gabrielfbdiniz/BMS-5S-L99BM114/BMS_5S_v2/fabrication/bom/mouser_bom_BMS_5S_L99BM114.csv

Manufacturer Part Number | Manufacturer | Quantity | Customer Reference | Description
L99BM114-TR | STMicroelectronics | 1 | IC1 | Automotive BMS Controller ASIC TQFP-64
HMU2103NL | Pulse Electronics | 2 | T1, T2 | Automotive Isolation Pulse Transformer 2.5kV SMD
USBLC6-2SC6 | STMicroelectronics | 2 | U2, U3 | Low Capacitance ESD Protection SOT-23-6
SMA6T68AY | STMicroelectronics | 1 | D1 | Automotive TVS Diode 600W SMA
STL8N10LF3 | STMicroelectronics | 1 | Q1 | N-Channel MOSFET 100V 8A PowerFLAT
STD105N10F7AG | STMicroelectronics | 1 | Q2 | Automotive N-Channel MOSFET 100V TO-252 DPAK
43045-1600 | Molex | 1 | J3 | Connector Header R/A 16 Pos Micro-Fit 3.0
43045-0400 | Molex | 2 | J4, J5 | Connector Header R/A 4 Pos Micro-Fit 3.0
CRCW201039R0FKEF | Vishay | 6 | R6, R9, R10, R13, R14, R17 | Resistor 39 Ohm 0.75W 1% 2010 SMD
CRCW0603100RFKEA | Vishay | 8 | R4, R7, R8, R11, R12, R15, R16, R25 | Resistor 100 Ohm 1/10W 1% 0603 SMD
CRCW060360R4FKEA | Vishay | 4 | R51, R52, R53, R54 | Resistor 60.4 Ohm 1/10W 1% 0603 SMD
CRCW2512100RFKEG | Vishay | 2 | R26, R27 | Resistor 100 Ohm 1W 1% 2512 SMD
CRCW251247R0FKEG | Vishay | 1 | R3 | Resistor 47 Ohm 1W 1% 2512 SMD
CRCW080510K0FKEA | Vishay | 8 | R33, R34, R35, R36, R41, R42, R43, R48 | Resistor 10k Ohm 1/8W 1% 0805 SMD
CRCW08053K90FKEA | Vishay | 7 | R37, R38, R39, R40, R44, R45, R46 | Resistor 3.9k Ohm 1/8W 1% 0805 SMD
CRCW060310K0FKEA | Vishay | 2 | R30, R55 | Resistor 10k Ohm 1/10W 1% 0603 SMD
CRCW0603100KFKEA | Vishay | 2 | R1, R31 | Resistor 100k Ohm 1/10W 1% 0603 SMD
CRCW06031K00FKEA | Vishay | 2 | R2, R5 | Resistor 1k Ohm 1/10W 1% 0603 SMD
CRCW06032K20FKEA | Vishay | 1 | R47 | Resistor 2.2k Ohm 1/10W 1% 0603 SMD
GRM188R72A473KE01D | Murata | 7 | C11, C13, C14, C17, C18, C21, C22 | Capacitor Ceramic 47nF 100V X7R 0603
GRM188R71H103KA01D | Murata | 6 | C12, C15, C16, C19, C20, C42 | Capacitor Ceramic 10nF 50V X7R 0603
GRM188R72A473KE01D | Murata | 2 | C23, C27 | Capacitor Ceramic 47nF 100V X7R 0603
GRM188R71H104KA93D | Murata | 7 | C35, C36, C37, C38, C39, C40, C41 | Capacitor Ceramic 100nF 50V X7R 0603
GRM1885C1H220JA01D | Murata | 4 | C44, C45, C47, C48 | Capacitor Ceramic 22pF 50V C0G 0603
GRM188R71H103KA01D | Murata | 2 | C43, C46 | Capacitor Ceramic 10nF 50V X7R 0603
GRM1885C2A101JA01D | Murata | 1 | C1 | Capacitor Ceramic 100pF 100V C0G 0603
C1608X7R2A333K080AA | TDK | 1 | C2 | Capacitor Ceramic 33nF 100V X7R 0603
GRM32ER72A225KA35L | Murata | 1 | C3 | Capacitor Ceramic 2.2uF 100V X7R 1210
GRM31CR71C475KA01L | Murata | 1 | C4 | Capacitor Ceramic 4.7uF 16V X7R 1206
GRM188R72A104KA35D | Murata | 1 | C5 | Capacitor Ceramic 100nF 100V X7R 0603
GRM188R71H472KA01D | Murata | 1 | C6 | Capacitor Ceramic 4.7nF 50V X7R 0603
GRM188R71C224KA01D | Murata | 1 | C7 | Capacitor Ceramic 220nF 16V X7R 0603
GRM21BR71A225KA01L | Murata | 1 | C8 | Capacitor Ceramic 2.2uF 10V X7R 0805
GRM21BR71C225KA12L | Murata | 1 | C9 | Capacitor Ceramic 2.2uF 16V X7R 0805
GRM21BR71E105KA99L | Murata | 1 | C10 | Capacitor Ceramic 1uF 25V X7R 0805
GRM32ER71C106KA12L | Murata | 1 | C24 | Capacitor Ceramic 10uF 16V X7R 1210
C0603C683K5RACTU | Kemet | 1 | C25 | Capacitor Ceramic 68nF 50V X7R 0603
GRM1885C1H330JA01D | Murata | 1 | C26 | Capacitor Ceramic 33pF 50V C0G 0603
GRM21BR71E105KA99L | Murata | 2 | C30, C33 | Capacitor Ceramic 1uF 25V X7R 0805
MMZ2012S102AT000 | TDK | 8 | FB1, FB2, FB3, FB4, FB5, FB6, FB7, FB8 | Ferrite Bead 1k Ohm @ 100MHz 0805
APT2012SGC | Kingbright | 1 | D4 | LED Super Bright Green 568nm 0805 SMD
