gabrielfbdiniz/BMS-5S-L99BM114/BMS_5S_v2/fabrication/bom/BMS_5S_L99BM114_bom.csv

Refs | Value | Footprint | Qty | DNP
C1 | 100pF/100V | Capacitor_SMD:C_0603_1608Metric_Pad1.08x0.95mm_HandSolder | 1
C2 | 33nF/100V | Capacitor_SMD:C_0603_1608Metric_Pad1.08x0.95mm_HandSolder | 1
C3 | 2u2F/100V | Capacitor_SMD:C_1210_3225Metric_Pad1.33x2.70mm_HandSolder | 1
C4 | 4u7F/16V | Capacitor_SMD:C_1206_3216Metric_Pad1.33x1.80mm_HandSolder | 1
C5 | 100nF/100V | Capacitor_SMD:C_0603_1608Metric_Pad1.08x0.95mm_HandSolder | 1
C6 | 4.7nF | Capacitor_SMD:C_0603_1608Metric_Pad1.08x0.95mm_HandSolder | 1
C7 | 220nF/16V | Capacitor_SMD:C_0603_1608Metric_Pad1.08x0.95mm_HandSolder | 1
C8 | 2u2F/6.3V | Capacitor_SMD:C_0805_2012Metric_Pad1.18x1.45mm_HandSolder | 1
C9 | 2u2F/16V | Capacitor_SMD:C_0805_2012Metric_Pad1.18x1.45mm_HandSolder | 1
C10 | 1uF/16V | Capacitor_SMD:C_0805_2012Metric_Pad1.18x1.45mm_HandSolder | 1
C11,C13,C14,C17,C18,C21,C22 | 47nF/100V | Capacitor_SMD:C_0603_1608Metric_Pad1.08x0.95mm_HandSolder | 7
C12,C15,C16,C19,C20,C42 | 10nF/50V | Capacitor_SMD:C_0603_1608Metric_Pad1.08x0.95mm_HandSolder | 6
C23,C27 | 47nF@100V | Capacitor_SMD:C_0603_1608Metric_Pad1.08x0.95mm_HandSolder | 2
C24 | 10uF@10V | Capacitor_SMD:C_1210_3225Metric_Pad1.33x2.70mm_HandSolder | 1
C25 | 68nF@10V | Capacitor_SMD:C_0603_1608Metric_Pad1.08x0.95mm_HandSolder | 1
C26 | 33pF@10V | Capacitor_SMD:C_0603_1608Metric_Pad1.08x0.95mm_HandSolder | 1
C30,C33 | 1uF | Capacitor_SMD:C_0805_2012Metric_Pad1.18x1.45mm_HandSolder | 2
C35-C41 | 100nF | Capacitor_SMD:C_0603_1608Metric_Pad1.08x0.95mm_HandSolder | 7
C43,C46 | 10nF | Capacitor_SMD:C_0603_1608Metric_Pad1.08x0.95mm_HandSolder | 2
C44,C45,C47,C48 | 22pF | Capacitor_SMD:C_0603_1608Metric_Pad1.08x0.95mm_HandSolder | 4
D1 | SMA6T68AY | DIOM5126X265N:DIOM5126X265N | 1
D4 | 3.2V | LED_SMD:LED_0805_2012Metric_Pad1.15x1.40mm_HandSolder | 1
FB1-FB8 | 1k@100MHz | Inductor_SMD:L_0805_2012Metric_Pad1.05x1.20mm_HandSolder | 8
IC1 | L99BM114-TR | Package_QFP:TQFP-64-1EP_10x10mm_P0.5mm_EP5.305x5.305mm | 1
J3 | Conector | Connector_Molex:Molex_Micro-Fit_3.0_43045-1600_2x08_P3.00mm_Horizontal | 1
J4,J5 | Conn_02x02_Counter_Clockwise | Connector_Molex:Molex_Micro-Fit_3.0_43045-0400_2x02_P3.00mm_Horizontal | 2
Q1 | STL8N10LF3 | STL8N10LF3:STL8N10LF3 | 1
Q2 | Q_NMOS_GDS | Package_TO_SOT_SMD:TO-252-2 | 1
R1,R31 | 100k | Resistor_SMD:R_0603_1608Metric_Pad0.98x0.95mm_HandSolder | 2
R2,R5 | 1k | Resistor_SMD:R_0603_1608Metric_Pad0.98x0.95mm_HandSolder | 2
R3 | 47 | Resistor_SMD:R_2512_6332Metric_Pad1.40x3.35mm_HandSolder | 1
R4,R7,R8,R11,R12,R15,R16,R25 | 100@1/16W | Resistor_SMD:R_0603_1608Metric_Pad0.98x0.95mm_HandSolder | 8
R6,R9,R10,R13,R14,R17 | 39@3/4W | Resistor_SMD:R_2010_5025Metric_Pad1.40x2.65mm_HandSolder | 6
R26,R27 | 100@1W | Resistor_SMD:R_2512_6332Metric_Pad1.40x3.35mm_HandSolder | 2
R30,R55 | 10k | Resistor_SMD:R_0603_1608Metric_Pad0.98x0.95mm_HandSolder | 2
R33-R36,R41-R43,R48 | 10k | Resistor_SMD:R_0805_2012Metric_Pad1.20x1.40mm_HandSolder | 8
R37-R40,R44-R46 | 3k9 | Resistor_SMD:R_0805_2012Metric_Pad1.20x1.40mm_HandSolder | 7
R47 | 2k2 | Resistor_SMD:R_0603_1608Metric_Pad0.98x0.95mm_HandSolder | 1
R49,R50 | 0R | Resistor_SMD:R_0603_1608Metric_Pad0.98x0.95mm_HandSolder | 2 | DNP
R51-R54 | 60.4 | Resistor_SMD:R_0603_1608Metric_Pad0.98x0.95mm_HandSolder | 4
T1,T2 | HMU2103NL | HMU2103NL:HMU2103NL | 2
U2,U3 | USBLC6-2SC6 | Package_TO_SOT_SMD:SOT-23-6 | 2
