gabrielfbdiniz/BMS-5S-L99BM114/BMS_5S_v2/3dmodels/HMU2103NL.stp

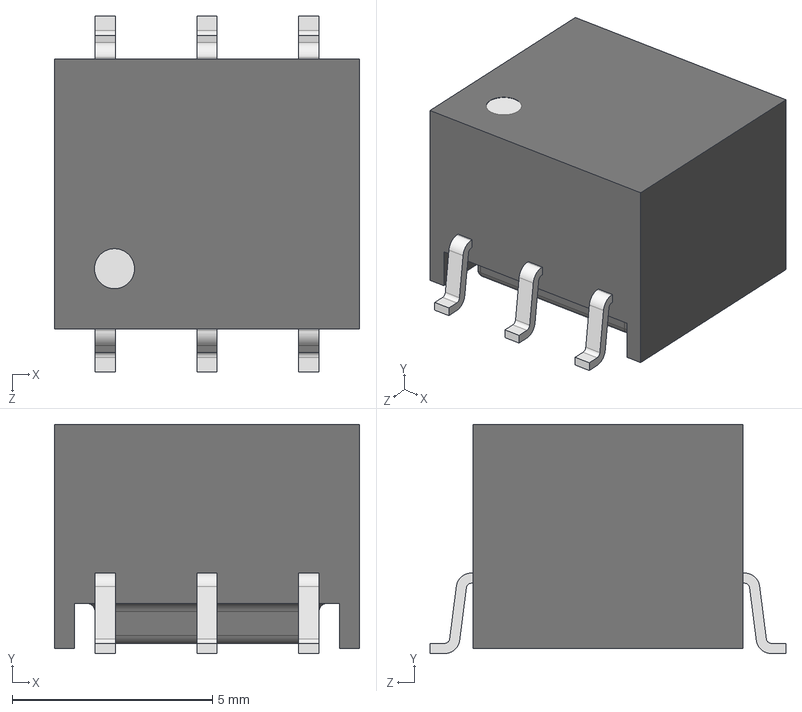
[picture p5: CAD file, 2026-10-21]
BMS_5S_v2/3dmodels/HMU2103NL.stp
7.62 x 5.72 x 8.89 mm
