gabrielfbdiniz/BMS-5S-L99BM114/BMS_5S_v2/3dmodels/Molex_43045-0400.step

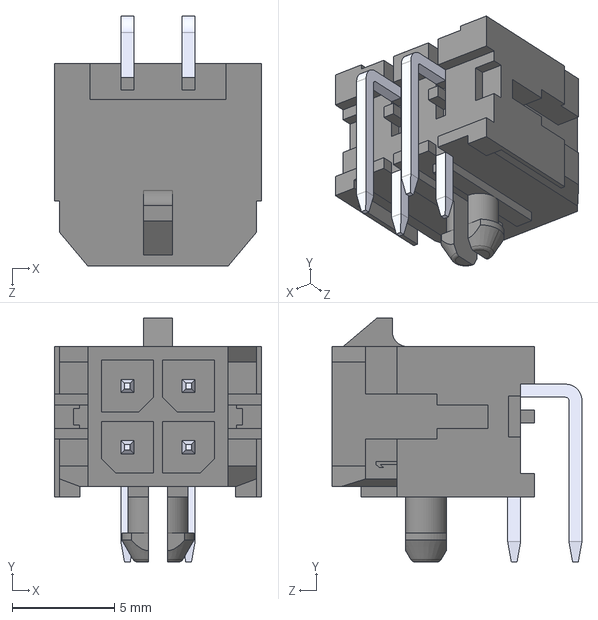
[picture p6: CAD file, 2026-10-21]
BMS_5S_v2/3dmodels/Molex_43045-0400.step
10.1 x 12.0 x 12.2 mm
