gabrielfbdiniz/BMS-5S-L99BM114/BMS_5S_v2/3dmodels/430451600.stp

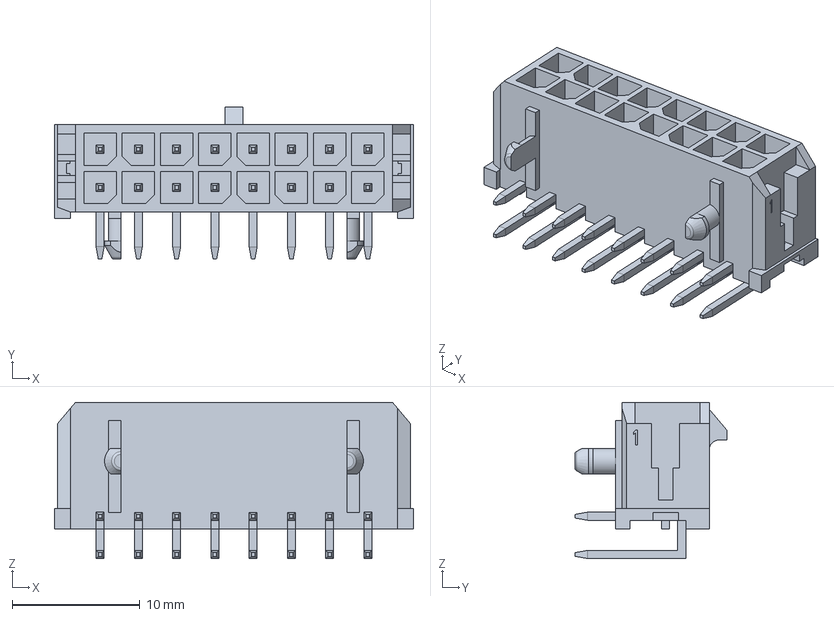
[picture p7: CAD file, 2026-10-21]
BMS_5S_v2/3dmodels/430451600.stp
28.1 x 11.9 x 12.2 mm
