gabrielfbdiniz/BMS-5S-L99BM114/BMS_5S_v2/fabrication/BMS_5S_L99BM114_Schematic.pdf

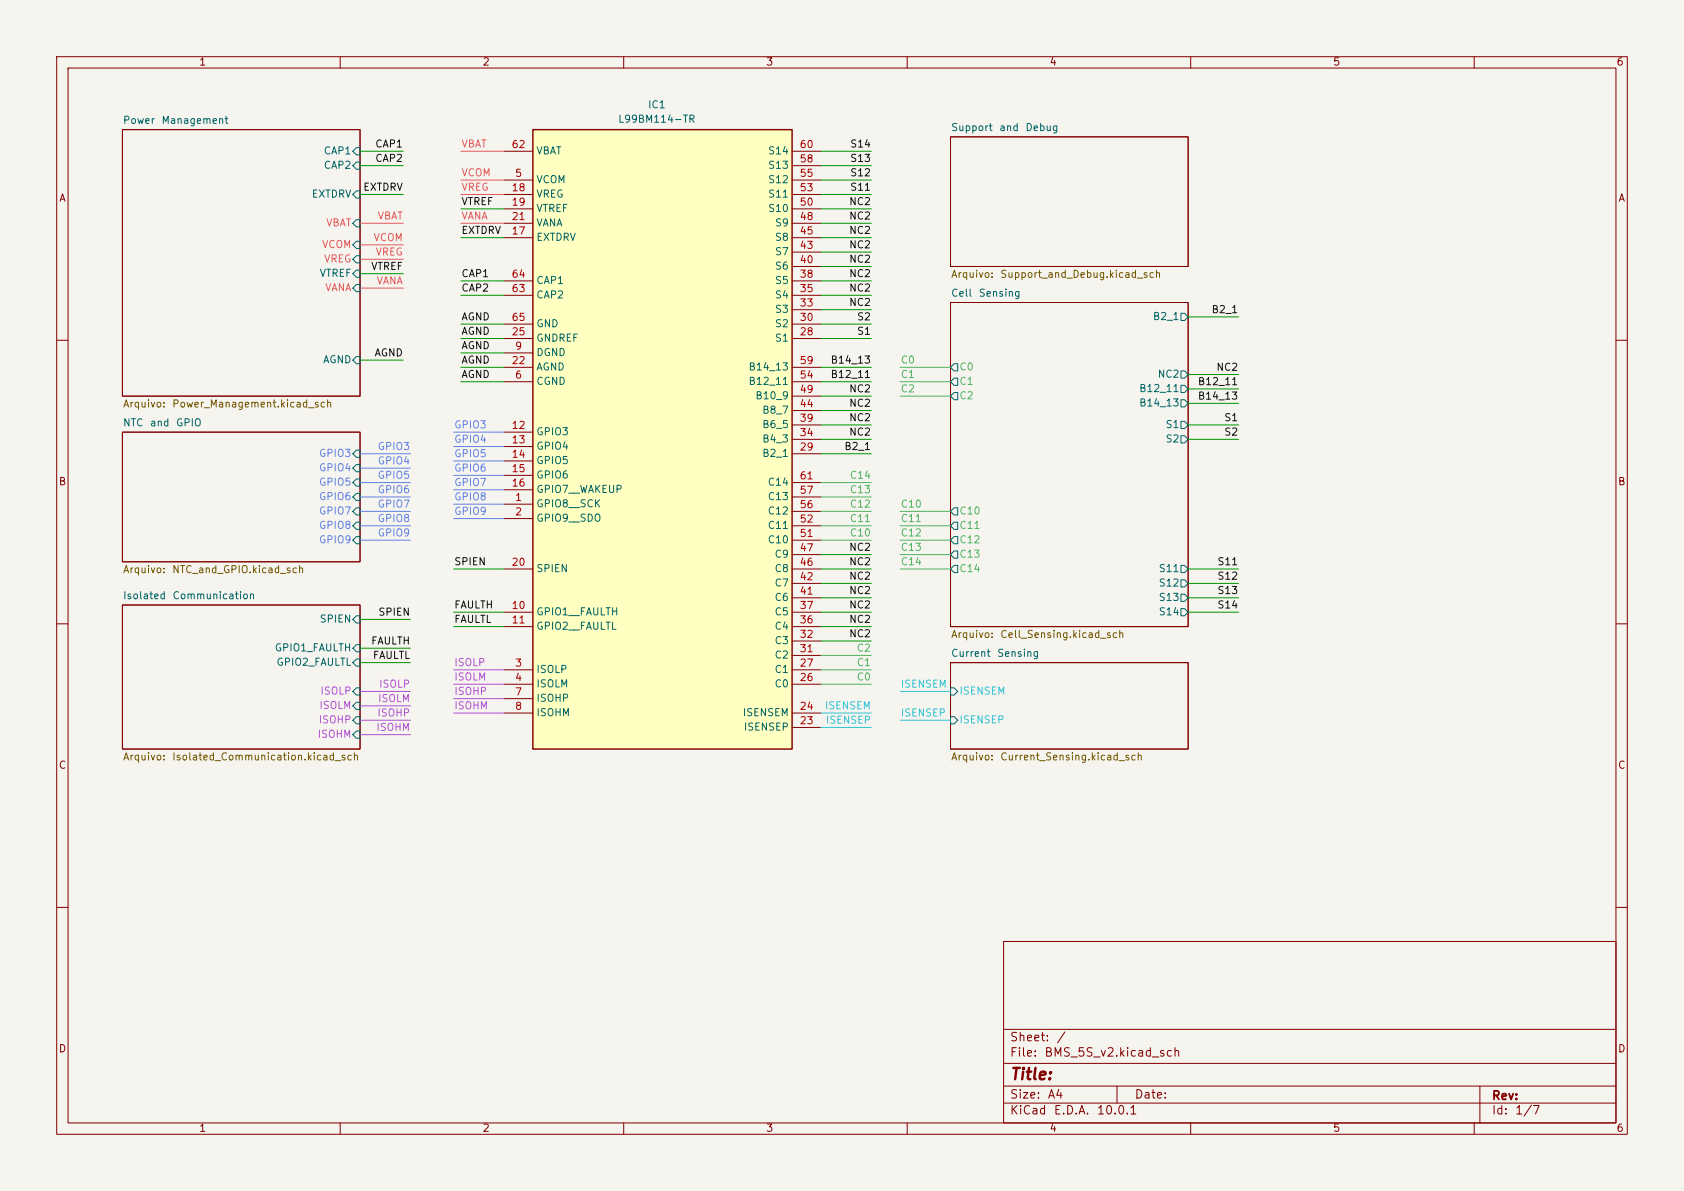
[picture p8: page 1]

Arquivo: Power_Management.kicad_sch
Arquivo: Cell_Sensing.kicad_sch GPIO3 GPIO4 GPIO5 GPIO6 GPIO7 GPIO8 GPIO9 NTC and GPIO

Size: A4 | Rev:
KiCad E.D.A. 10.0.1 | Id: 1/7

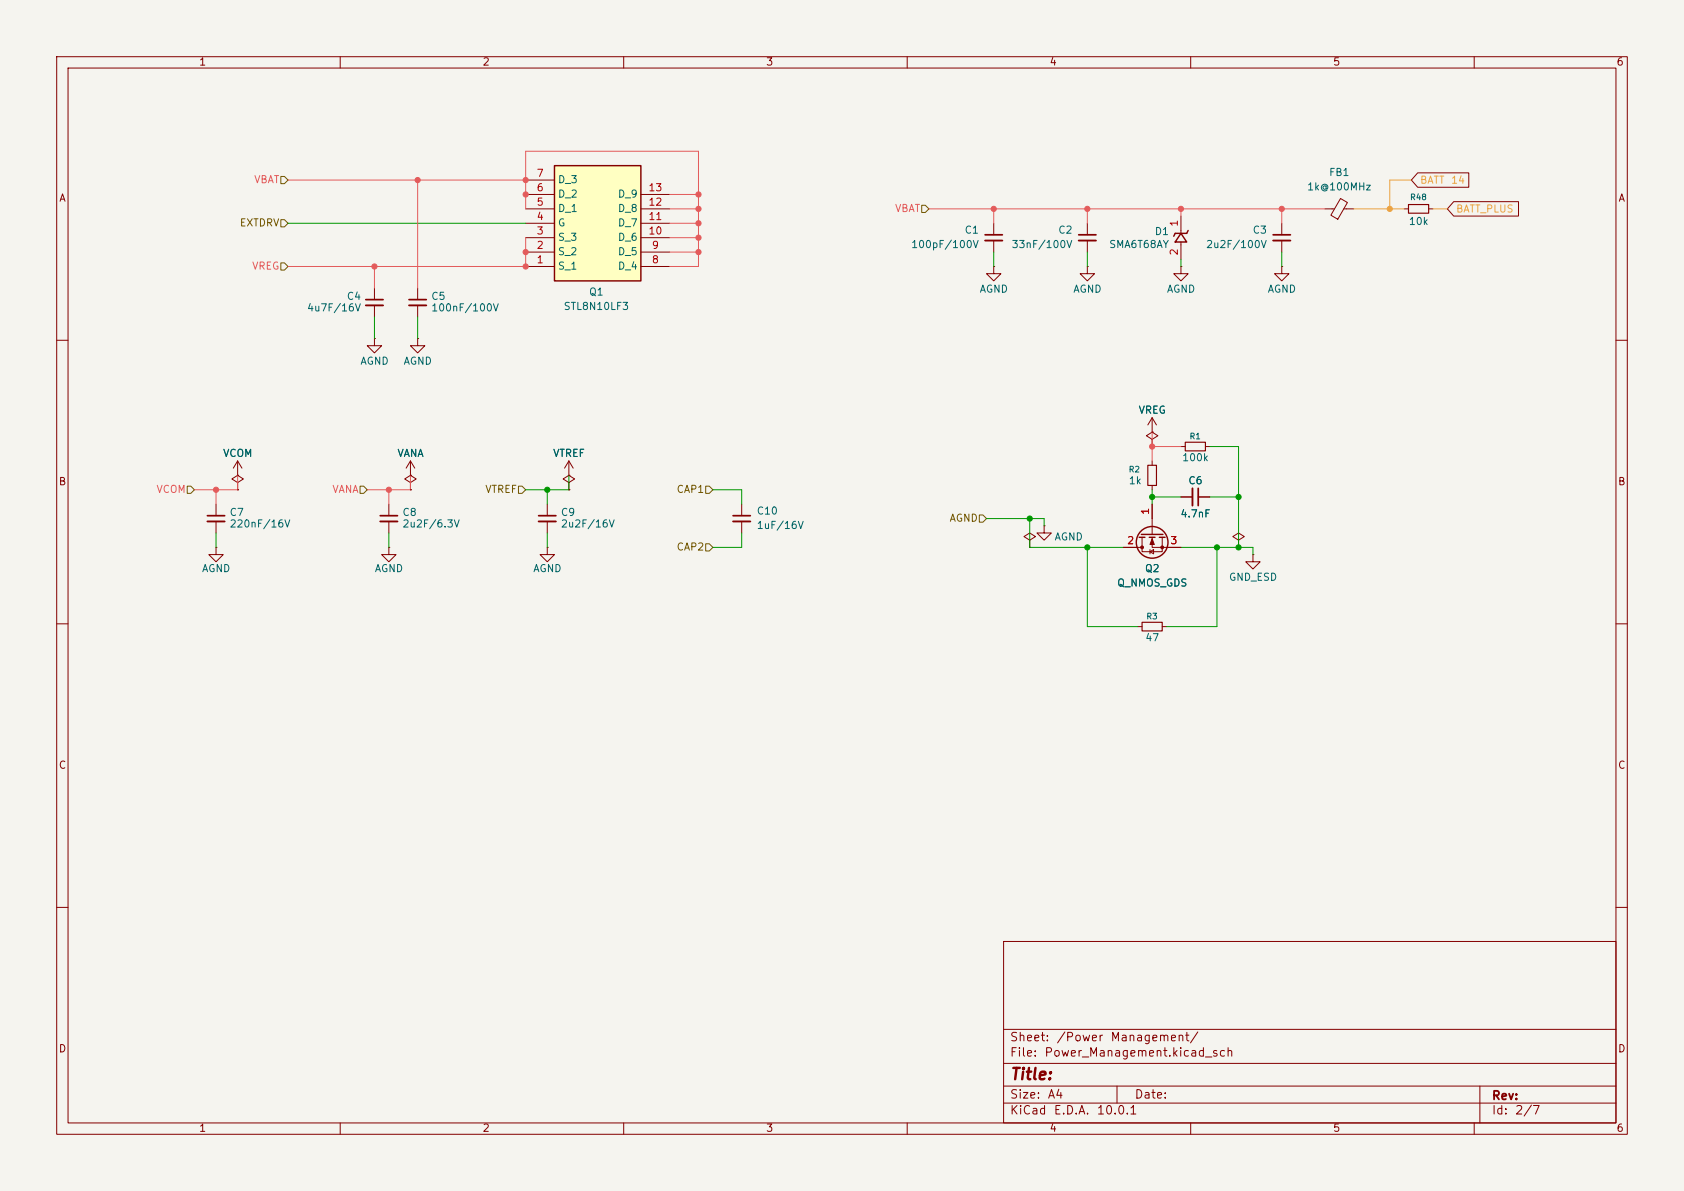
[picture p9: page 2]

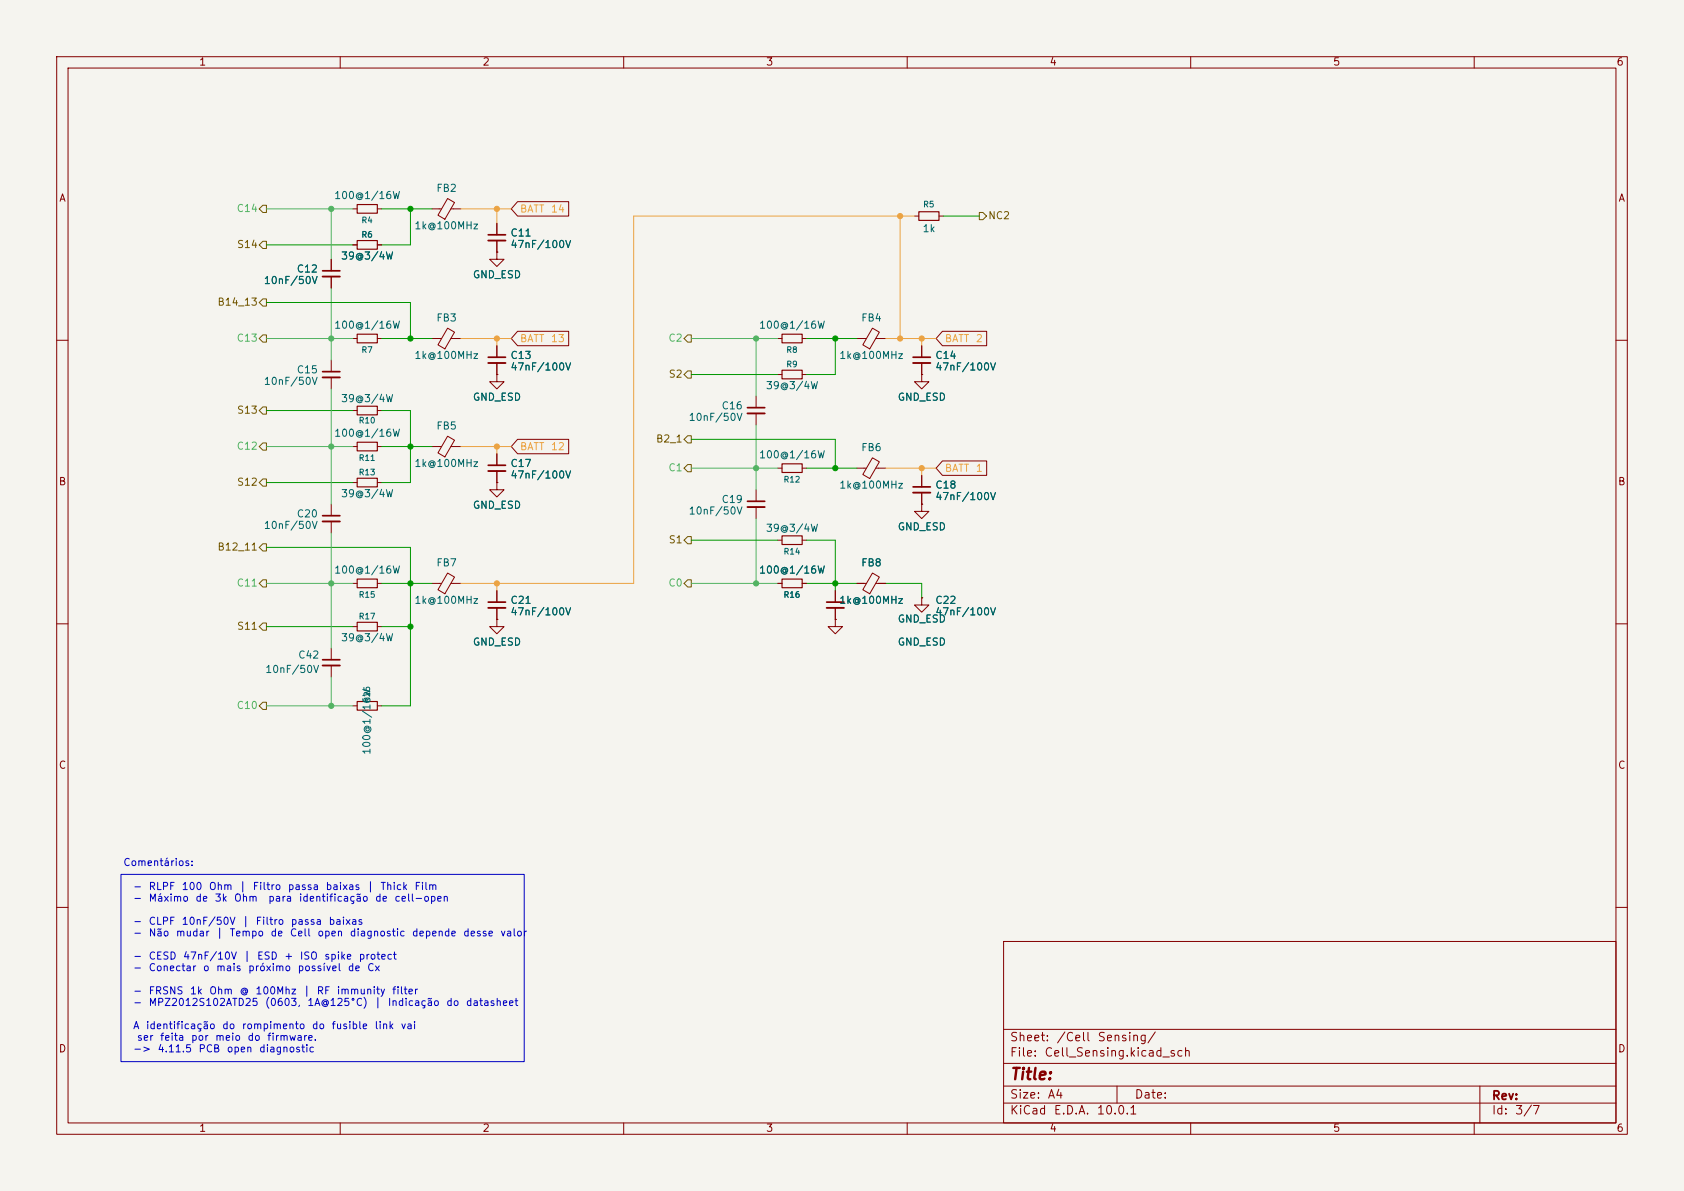
[picture p10: page 3]

- Máximo de 3k Ohm para identificação de cell-open - CLPF 10nF/50V | Filtro passa baixas - Não mudar | Tempo de Cell open diagnostic depende desse valor - CESD 47nF/10V | ESD + ISO spike protect - Conectar o mais próximo possível de Cx - FRSNS 1k Ohm @ 100Mhz | RF immunity filter - MPZ2012S102ATD25 (0603, 1A@125°C) | Indicação do datasheet A identificação do rompimento do fusible link vai ser feita por meio do firmware. -> 4.11.5 PCB open diagnostic

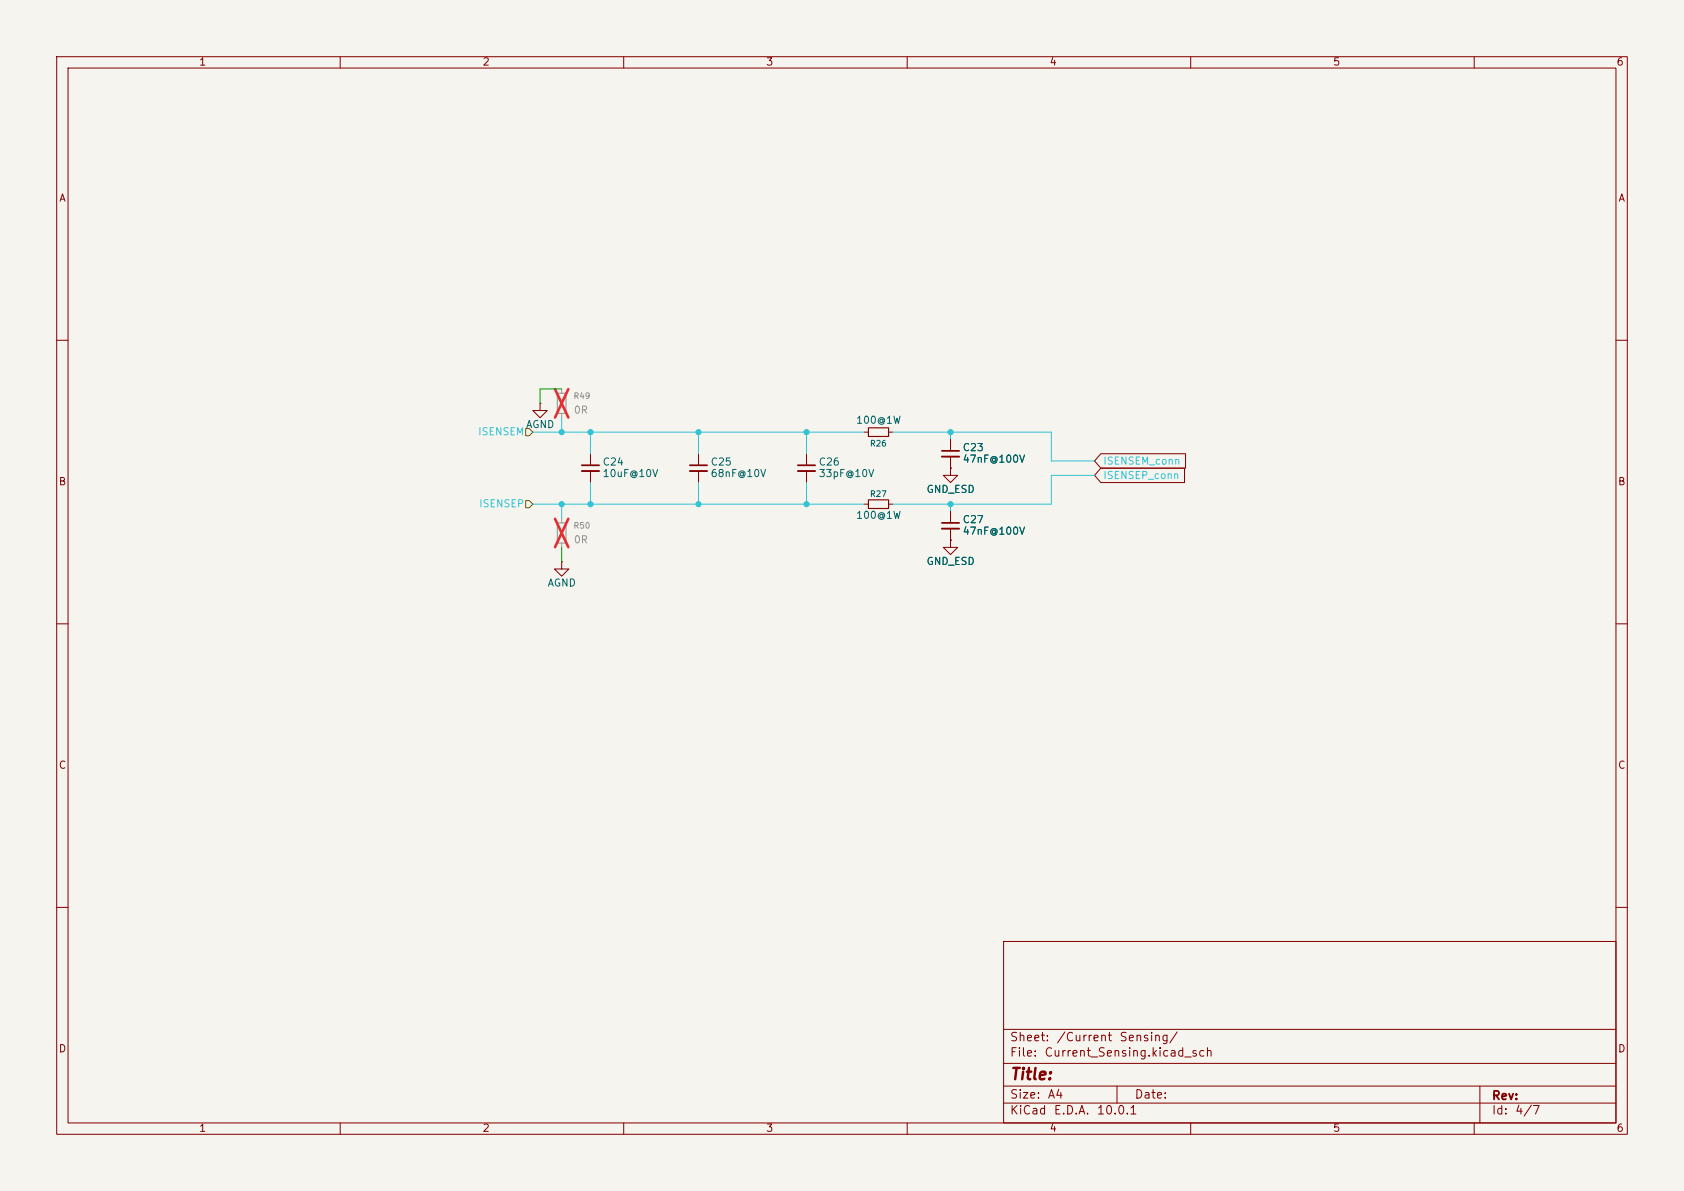
[picture p11: page 4]

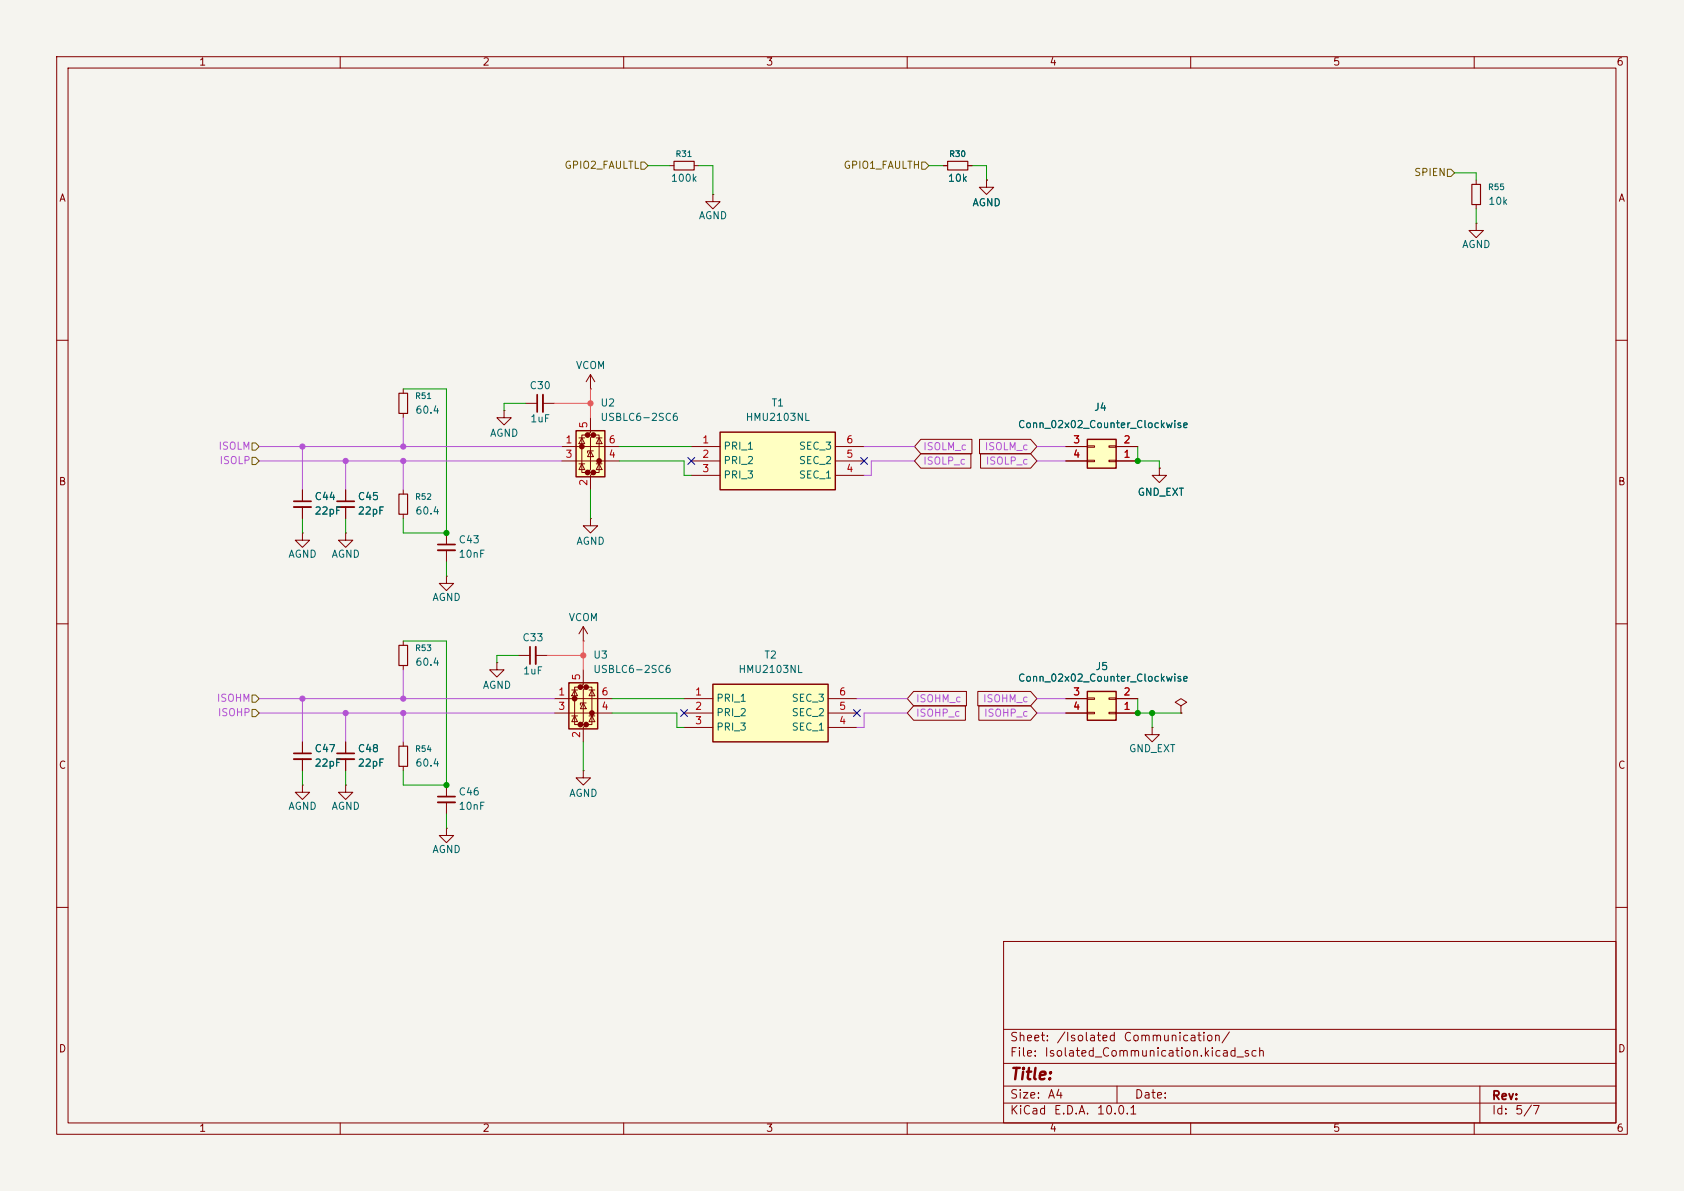
[picture p12: page 5]

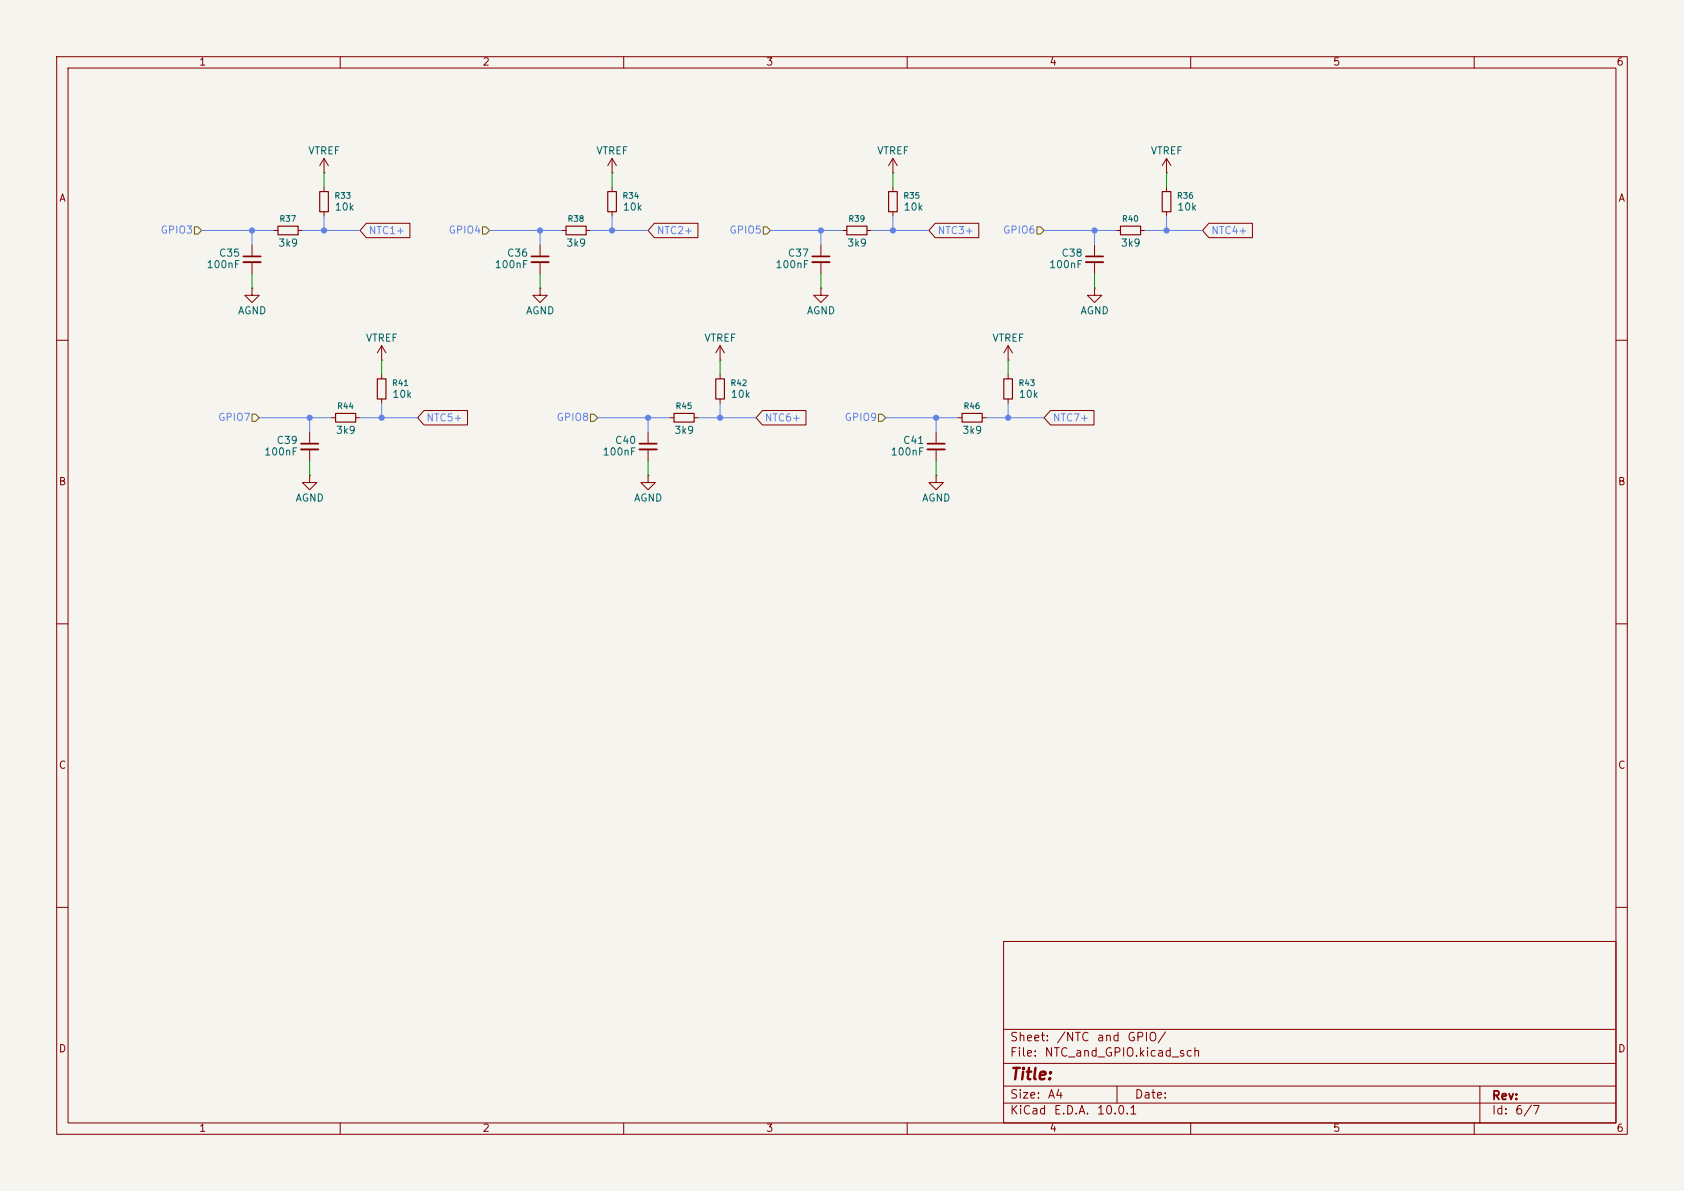
[picture p13: page 6]

Sheet: /NTC and GPIO/
File: NTC_and_GPIO.kicad_sch
Title:

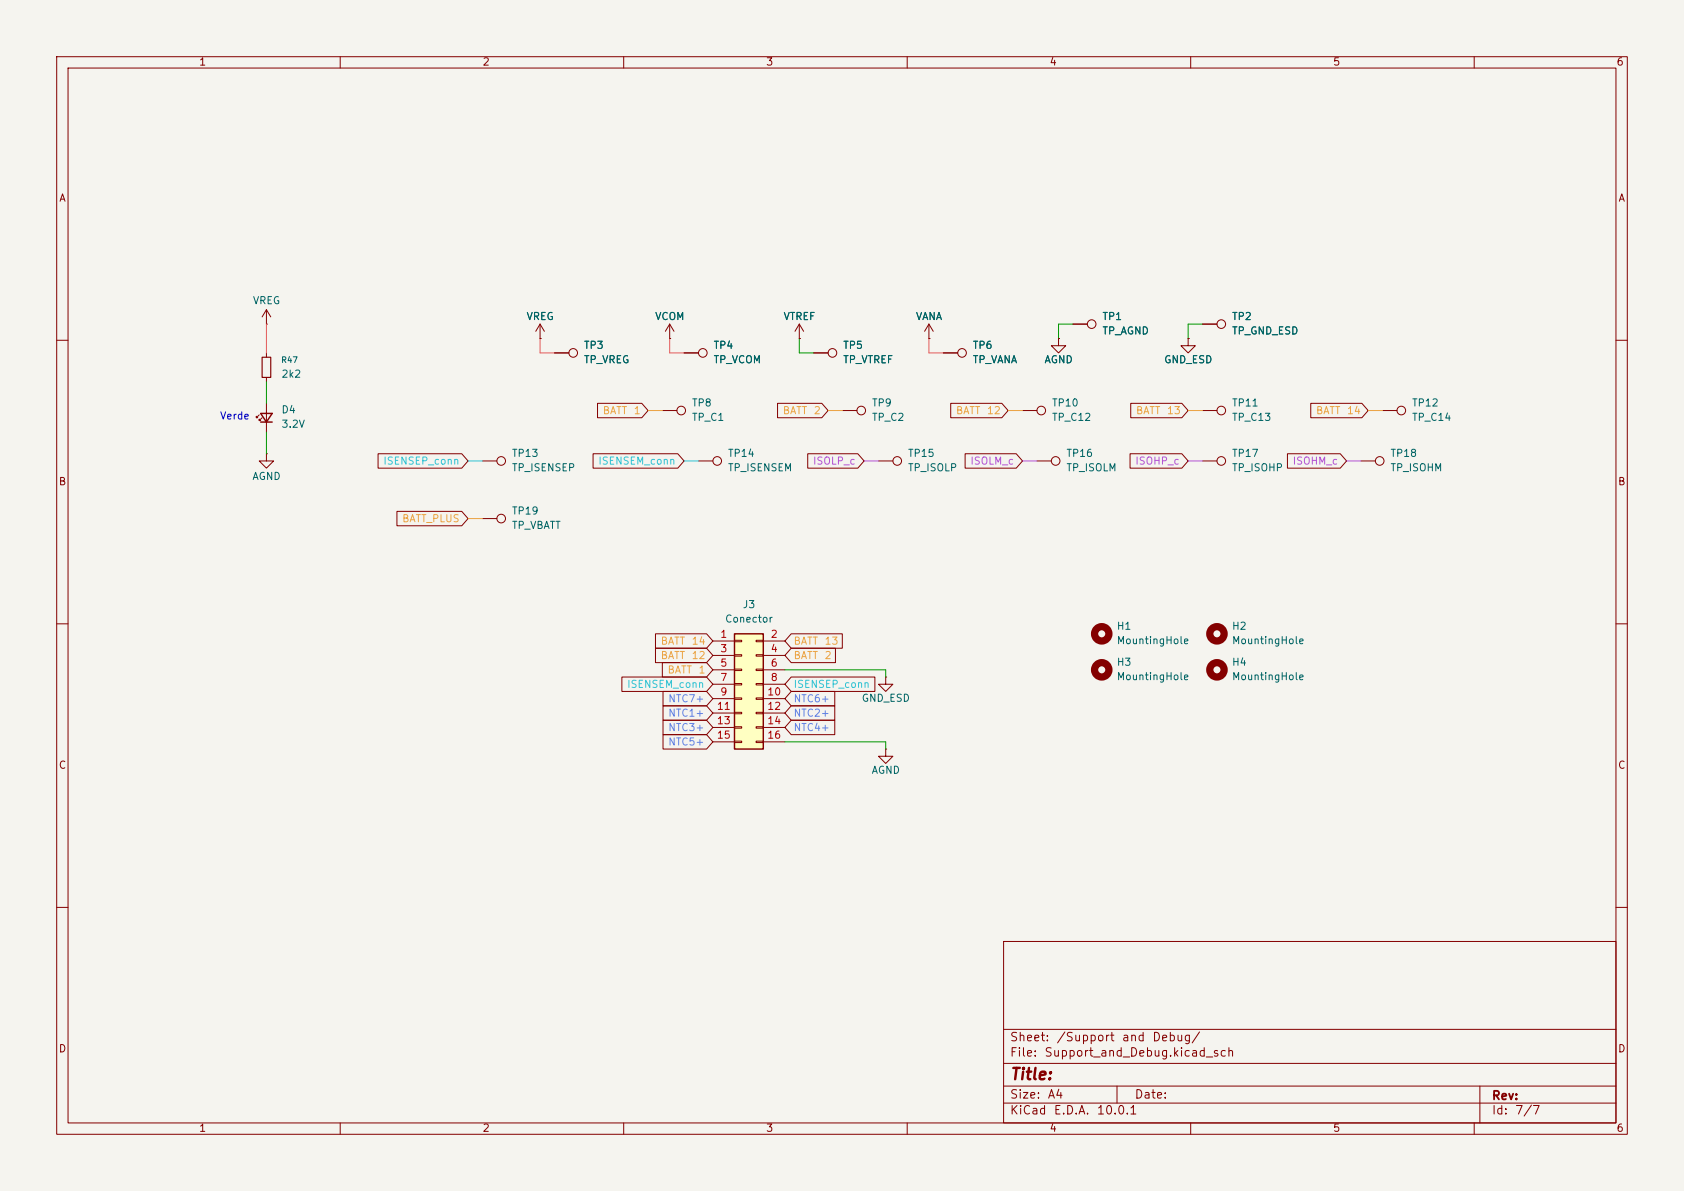
[picture p14: page 7]

Sheet: /Support and Debug/
File: Support_and_Debug.kicad_sch
Title:
