gabrielfbdiniz/BMS-5S-L99BM114/BMS_5S_v2/BMS_5S_v2.kicad_pcb

## KiCad design BMS_5S_v2/BMS_5S_v2.kicad_pcb (2026-10-22)

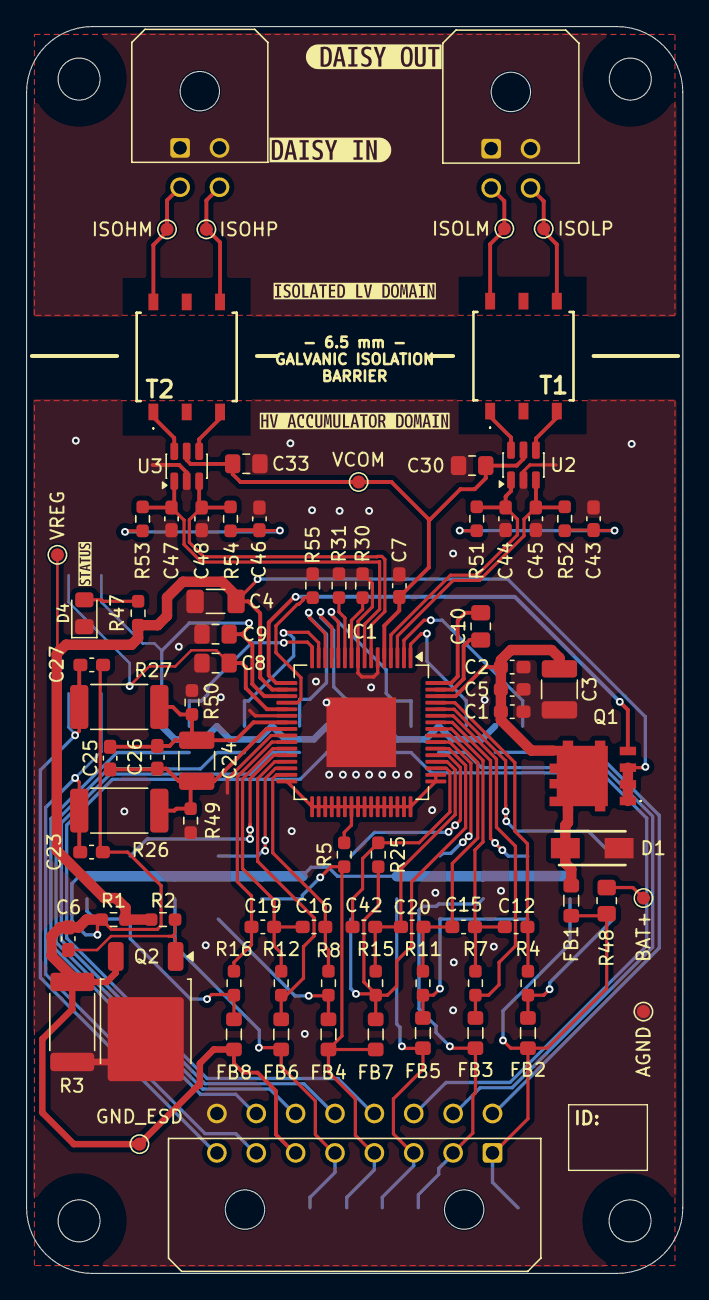
[picture p15: board BMS_5S_v2.kicad_pcb from above]

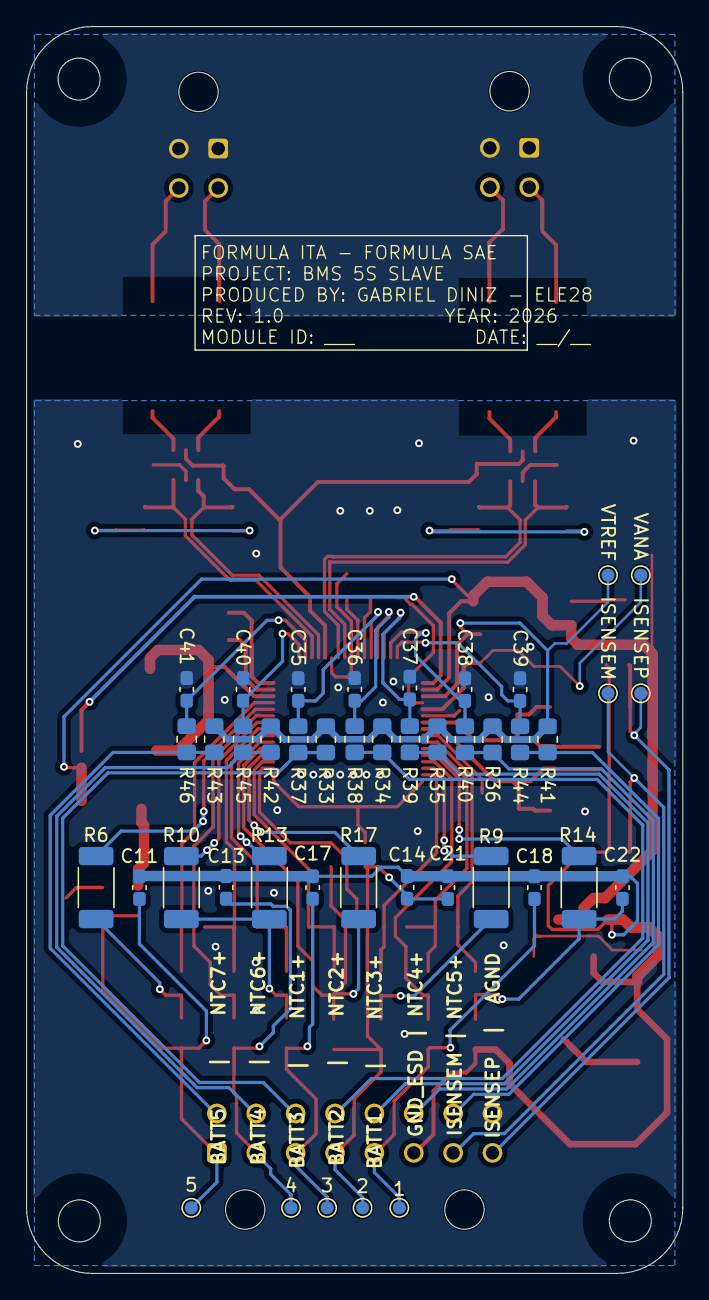
[picture p16: board BMS_5S_v2.kicad_pcb from below]

Board: 4 copper layers, 50.0 x 95.0 mm, 135 parts (43 on the bottom side), 76 nets.

Parts:
1: TP_C1; TestPoint_Pad_D1.0mm
2: TP_C2; TestPoint_Pad_D1.0mm
3: TP_C12; TestPoint_Pad_D1.0mm
4: TP_C13; TestPoint_Pad_D1.0mm
5: TP_C14; TestPoint_Pad_D1.0mm
AGND: TP_AGND; TestPoint_Pad_D1.0mm
BAT+: TP_VBATT; TestPoint_Pad_D1.0mm
C1: 100pF/100V; C_0603_1608Metric_Pad1.08x0.95mm_HandSolder
C2: 33nF/100V; C_0603_1608Metric_Pad1.08x0.95mm_HandSolder
C3: 2u2F/100V; C_1210_3225Metric_Pad1.33x2.70mm_HandSolder
C4: 4u7F/16V; C_1206_3216Metric_Pad1.33x1.80mm_HandSolder
C5: 100nF/100V; C_0603_1608Metric_Pad1.08x0.95mm_HandSolder
C6: 4.7nF; C_0603_1608Metric_Pad1.08x0.95mm_HandSolder
C7: 220nF/16V; C_0603_1608Metric_Pad1.08x0.95mm_HandSolder
C8: 2u2F/6.3V; C_0805_2012Metric_Pad1.18x1.45mm_HandSolder
C9: 2u2F/16V; C_0805_2012Metric_Pad1.18x1.45mm_HandSolder
C10: 1uF/16V; C_0805_2012Metric_Pad1.18x1.45mm_HandSolder
C11, C13, C14, C17, C18, C21, C22: 47nF/100V; C_0603_1608Metric_Pad1.08x0.95mm_HandSolder
C12, C15, C16, C19, C20, C42: 10nF/50V; C_0603_1608Metric_Pad1.08x0.95mm_HandSolder
C23, C27: 47nF@100V; C_0603_1608Metric_Pad1.08x0.95mm_HandSolder
C24: 10uF@10V; C_1210_3225Metric_Pad1.33x2.70mm_HandSolder
C25: 68nF@10V; C_0603_1608Metric_Pad1.08x0.95mm_HandSolder
C26: 33pF@10V; C_0603_1608Metric_Pad1.08x0.95mm_HandSolder
C30, C33: 1uF; C_0805_2012Metric_Pad1.18x1.45mm_HandSolder
C35, C36, C37, C38, C39, C40, C41: 100nF; C_0603_1608Metric_Pad1.08x0.95mm_HandSolder
C43, C46: 10nF; C_0603_1608Metric_Pad1.08x0.95mm_HandSolder
C44, C45, C47, C48: 22pF; C_0603_1608Metric_Pad1.08x0.95mm_HandSolder
D1: SMA6T68AY; DIOM5126X265N
D4: 3.2V; LED_0805_2012Metric_Pad1.15x1.40mm_HandSolder
FB1, FB2, FB3, FB4, FB5, FB6, FB7, FB8: 1k@100MHz; L_0805_2012Metric_Pad1.05x1.20mm_HandSolder
GND_ESD: TP_GND_ESD; TestPoint_Pad_D1.0mm
H1, H2, H3, H4: MountingHole; MountingHole_3.2mm_M3_DIN965
IC1: L99BM114-TR; TQFP-64-1EP_10x10mm_P0.5mm_EP5.305x5.305mm
ISENSEM: TP_ISENSEM; TestPoint_Pad_D1.0mm
ISENSEP: TP_ISENSEP; TestPoint_Pad_D1.0mm
ISOHM: TP_ISOHM; TestPoint_Pad_D1.0mm
ISOHP: TP_ISOHP; TestPoint_Pad_D1.0mm
ISOLM: TP_ISOLM; TestPoint_Pad_D1.0mm
ISOLP: TP_ISOLP; TestPoint_Pad_D1.0mm
J3: Conector; Molex_Micro-Fit_3.0_43045-1600_2x08_P3.00mm_Horizontal
J4, J5: Conn_02x02_Counter_Clockwise; Molex_Micro-Fit_3.0_43045-0400_2x02_P3.00mm_Horizontal
Q1: STL8N10LF3
Q2: Q_NMOS_GDS; TO-252-2
R1, R31: 100k; R_0603_1608Metric_Pad0.98x0.95mm_HandSolder
R2, R5: 1k; R_0603_1608Metric_Pad0.98x0.95mm_HandSolder
R3: 47; R_2512_6332Metric_Pad1.40x3.35mm_HandSolder
R4, R7, R8, R11, R12, R15, R16, R25: 100@1/16W; R_0603_1608Metric_Pad0.98x0.95mm_HandSolder
R6, R9, R10, R13, R14, R17: 39@3/4W; R_2010_5025Metric_Pad1.40x2.65mm_HandSolder
R26, R27: 100@1W; R_2512_6332Metric_Pad1.40x3.35mm_HandSolder
R30, R55: 10k; R_0603_1608Metric_Pad0.98x0.95mm_HandSolder
R33, R34, R35, R36, R41, R42, R43, R48: 10k; R_0805_2012Metric_Pad1.20x1.40mm_HandSolder
R37, R38, R39, R40, R44, R45, R46: 3k9; R_0805_2012Metric_Pad1.20x1.40mm_HandSolder
R47: 2k2; R_0603_1608Metric_Pad0.98x0.95mm_HandSolder
R49, R50: 0R; R_0603_1608Metric_Pad0.98x0.95mm_HandSolder
R51, R52, R53, R54: 60.4; R_0603_1608Metric_Pad0.98x0.95mm_HandSolder
T1, T2: HMU2103NL
U2, U3: USBLC6-2SC6; SOT-23-6
VANA: TP_VANA; TestPoint_Pad_D1.0mm
VCOM: TP_VCOM; TestPoint_Pad_D1.0mm
VREG: TP_VREG; TestPoint_Pad_D1.0mm
VTREF: TP_VTREF; TestPoint_Pad_D1.0mm
kibuzzard-6AD93452: G***; kibuzzard-6AD93452
kibuzzard-6AD93460: G***; kibuzzard-6AD93460
kibuzzard-6ADA909C: G***; kibuzzard-6ADA909C
kibuzzard-6ADA916E: G***; kibuzzard-6ADA916E
kibuzzard-6ADA9153: G***; kibuzzard-6ADA9153

Connections:
/B2_1: FB6.1, IC1.29 (B2_1), R12.2
/B12_11: FB7.1, IC1.54 (B12_11), R15.2, R17.2, R25.2
/B14_13: FB3.1, IC1.59 (B14_13), R7.2
/C0: C19.2, IC1.26 (C0), R16.1
/C1: C16.2, C19.1, IC1.27 (C1), R12.1
/C2: C16.1, IC1.31 (C2), R8.1
/C10: C42.2, IC1.51 (C10), R25.1
/C11: C20.2, C42.1, IC1.52 (C11), R15.1
/C12: C15.2, C20.1, IC1.56 (C12), R11.1
/C13: C12.2, C15.1, IC1.57 (C13), R7.1
/C14: C12.1, IC1.61 (C14), R4.1
/CAP1: C10.1, IC1.64 (CAP1)
/CAP2: C10.2, IC1.63 (CAP2)
/EXTDRV: IC1.17 (EXTDRV), Q1.4 (G)
/FAULTH: IC1.10 (GPIO1__FAULTH), R30.1
/FAULTL: IC1.11 (GPIO2__FAULTL), R31.1
/GPIO3: C35.1, IC1.12 (GPIO3), R37.1
/GPIO4: C36.1, IC1.13 (GPIO4), R38.1
/GPIO5: C37.1, IC1.14 (GPIO5), R39.1
/GPIO6: C38.1, IC1.15 (GPIO6), R40.1
/GPIO7: C39.1, IC1.16 (GPIO7__WAKEUP), R44.1
/GPIO8: C40.1, IC1.1 (GPIO8__SCK), R45.1
/GPIO9: C41.1, IC1.2 (GPIO9__SDO), R46.1
/ISENSEM: C24.1, C25.1, C26.1, IC1.24 (ISENSEM), R26.1, R49.2
/ISENSEP: C24.2, C25.2, C26.2, IC1.23 (ISENSEP), R27.2, R50.1
/ISOHM: C47.1, IC1.8 (ISOHM), R53.2, U3.1 (I/O1)
/ISOHP: C48.1, IC1.7 (ISOHP), R54.1, U3.3 (I/O2)
/ISOLM: C44.1, IC1.4 (ISOLM), R51.2, U2.1 (I/O1)
/ISOLP: C45.1, IC1.3 (ISOLP), R52.1, U2.3 (I/O2)
/NC2: IC1.32 (C3), IC1.33 (S3), IC1.34 (B4_3), IC1.35 (S4), IC1.36 (C4), IC1.37 (C5), IC1.38 (S5), IC1.39 (B6_5), IC1.40 (S6), IC1.41 (C6), IC1.42 (C7), IC1.43 (S7), IC1.44 (B8_7), IC1.45 (S8), IC1.46 (C8), IC1.47 (C9), IC1.48 (S9), IC1.49 (B10_9), IC1.50 (S10), R5.2
/S1: IC1.28 (S1), R14.1
/S2: IC1.30 (S2), R9.1
/S11: IC1.53 (S11), R17.1
/S12: IC1.55 (S12), R13.1
/S13: IC1.58 (S13), R10.1
/S14: IC1.60 (S14), R6.1
/SPIEN: IC1.20 (SPIEN), R55.1
/VBAT: C1.1, C2.1, C3.1, C5.1, D1.1 (K), FB1.1, IC1.62 (VBAT), Q1.5 (D_1), Q1.6 (D_2), Q1.7 (D_3), Q1.8 (D_4), Q1.9 (D_5), Q1.10 (D_6), Q1.11 (D_7), Q1.12 (D_8), Q1.13 (D_9)
AGND: AGND.1, C1.2, C2.2, C3.2, C4.2, C5.2, C7.2, C8.2, C9.2, C30.1, C33.1, C35.2, C36.2, C37.2, C38.2, C39.2, C40.2, C41.2, C43.2, C44.2, C45.2, C46.2, C47.2, C48.2, D1.2 (A), D4.1 (K), IC1.6 (CGND), IC1.9 (DGND), IC1.22 (AGND), IC1.25 (GNDREF), IC1.65 (GND), J3.16, Q2.2 (D), R3.1, R30.2, R31.2, R49.1, R50.2, R55.2, U2.2 (GND), U3.2 (GND)
BATT 1: 1.1, C18.1, FB6.2, J3.5
BATT 2: 2.1, C14.1, C21.1, FB4.2, FB7.2, J3.4, R5.1
BATT 12: 3.1, C17.1, FB5.2, J3.3
BATT 13: 4.1, C13.1, FB3.2, J3.2
BATT 14: 5.1, C11.1, FB1.2, FB2.2, J3.1, R48.1
BATT_PLUS: BAT+.1, R48.2
GND_ESD: C6.1, C11.2, C13.2, C14.2, C17.2, C18.2, C21.2, C22.2, C23.2, C27.2, FB8.2, GND_ESD.1, J3.6, Q2.3 (S), R1.1, R3.2
GND_EXT: J4.1, J4.2, J5.1, J5.2
ISENSEM_conn: C23.1, ISENSEM.1, J3.7, R26.2
ISENSEP_conn: C27.1, ISENSEP.1, J3.8, R27.1
ISOHM_c: ISOHM.1, J5.3, T2.6 (SEC_3)
ISOHP_c: ISOHP.1, J5.4, T2.4 (SEC_1)
ISOLM_c: ISOLM.1, J4.3, T1.6 (SEC_3)
ISOLP_c: ISOLP.1, J4.4, T1.4 (SEC_1)
NTC1+: J3.11, R33.1, R37.2
NTC2+: J3.12, R34.1, R38.2
NTC3+: J3.13, R35.1, R39.2
NTC4+: J3.14, R36.1, R40.2
NTC5+: J3.15, R41.1, R44.2
NTC6+: J3.10, R42.1, R45.2
NTC7+: J3.9, R43.1, R46.2
unnamed: C22.1, FB8.1, R14.2, R16.2
unnamed: C43.1, R51.1, R52.2
unnamed: C46.1, R53.1, R54.2
unnamed: D4.2 (A), R47.2
unnamed: FB2.1, R4.2, R6.2
unnamed: FB4.1, R8.2, R9.2
unnamed: FB5.1, R10.2, R11.2, R13.2
unnamed: C6.2, Q2.1 (G), R2.2
unnamed: T1.1 (PRI_1), U2.6 (I/O1)
unnamed: T1.3 (PRI_3), U2.4 (I/O2)
unnamed: T2.1 (PRI_1), U3.6 (I/O1)
unnamed: T2.3 (PRI_3), U3.4 (I/O2)
VANA: C8.1, IC1.21 (VANA), VANA.1
VCOM: C7.1, C30.2, C33.2, IC1.5 (VCOM), U2.5 (VBUS), U3.5 (VBUS), VCOM.1
VREG: C4.1, IC1.18 (VREG), Q1.1 (S_1), Q1.2 (S_2), Q1.3 (S_3), R1.2, R2.1, R47.1, VREG.1
VTREF: C9.1, IC1.19 (VTREF), R33.2, R34.2, R35.2, R36.2, R41.2, R42.2, R43.2, VTREF.1
