gabrielfbdiniz/BMS-5S-L99BM114/(commit log)

2026-10-21 feat: initial release of BMS-5S-L99BM114
    [BMS_5S_L99BM114_bom.csv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]
2026-10-21 feat(3d): integrate official manufacturer STEP models for transformers and Molex connectors
    [430451600.stp, BMS_5S_v2.kicad_pcb, HMU2103NL.stp]
2026-10-21 fix(3d): calibrate Molex connector orientation and pin alignment, update renders
    [BMS_5S_v2.kicad_pcb]
2026-10-21 fix(silkscreen): correct J5 label from DAISE OUT to DAISY OUT and update renders
    [BMS_5S_v2.kicad_pcb]
2026-10-22 fix: resolve hardware audit issues, update documentation, fabrication package, and 3D renders
    [BMS_5S_L99BM114_bom.csv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]
2026-10-24 docs: add operational and assembly manual, update schematic export, and refresh 3D renders
2026-10-24 refactor(repo): organize fabrication files, clean obsolete artifacts, and consolidate hardware libraries
    [430451600.stp, BMS_5S_v2_bom.csv, HMU2103NL.stp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]
2026-10-24 docs(bom): group BOM references by value and footprint
    [BMS_5S_L99BM114_bom.csv]
2026-10-24 docs(bom): add Mouser-ready BOM CSV with manufacturer part numbers
    [mouser_bom_BMS_5S_L99BM114.csv]
