gabrielfbdiniz/BMS-5S-L99BM114/(notices)

Notices in the files:
README.md:
License: CERN-OHL-S v2
